tkircher/Espresso_vacuum/README.md

# Espresso vacuum
Released under the Permissive version of the Cern Open Hardware License v2 (CERN-OHL-P)
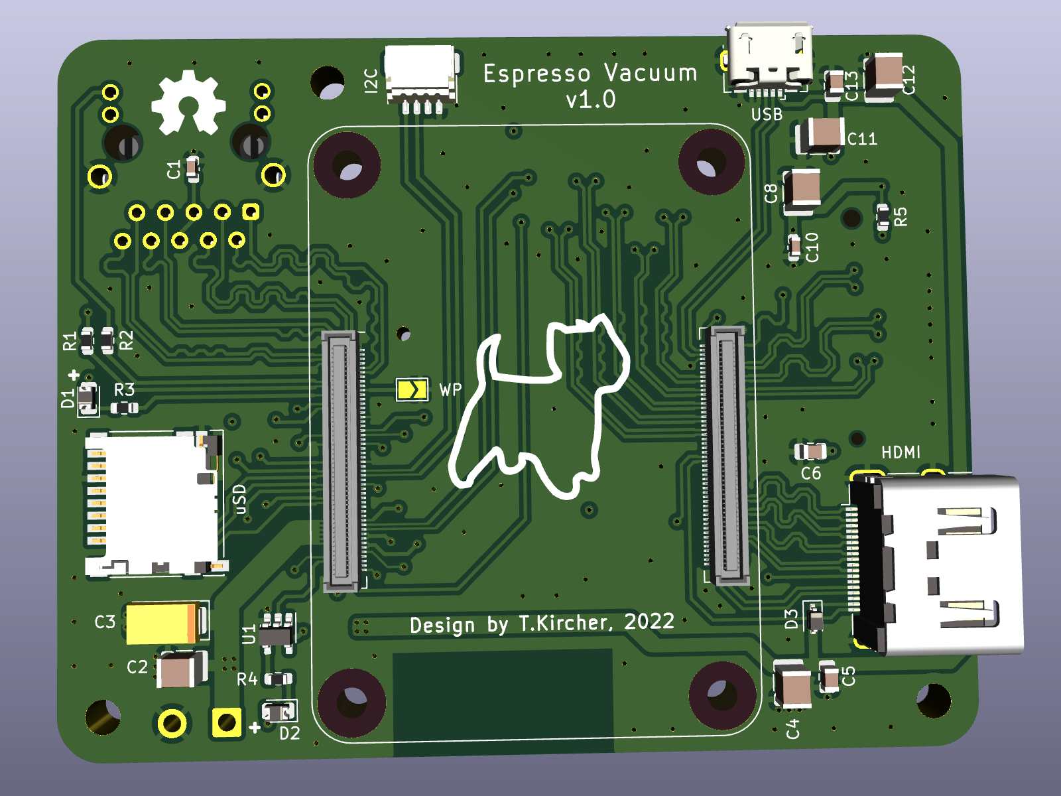
[picture p1: Espresso_vacuum_front.png]
Board front view

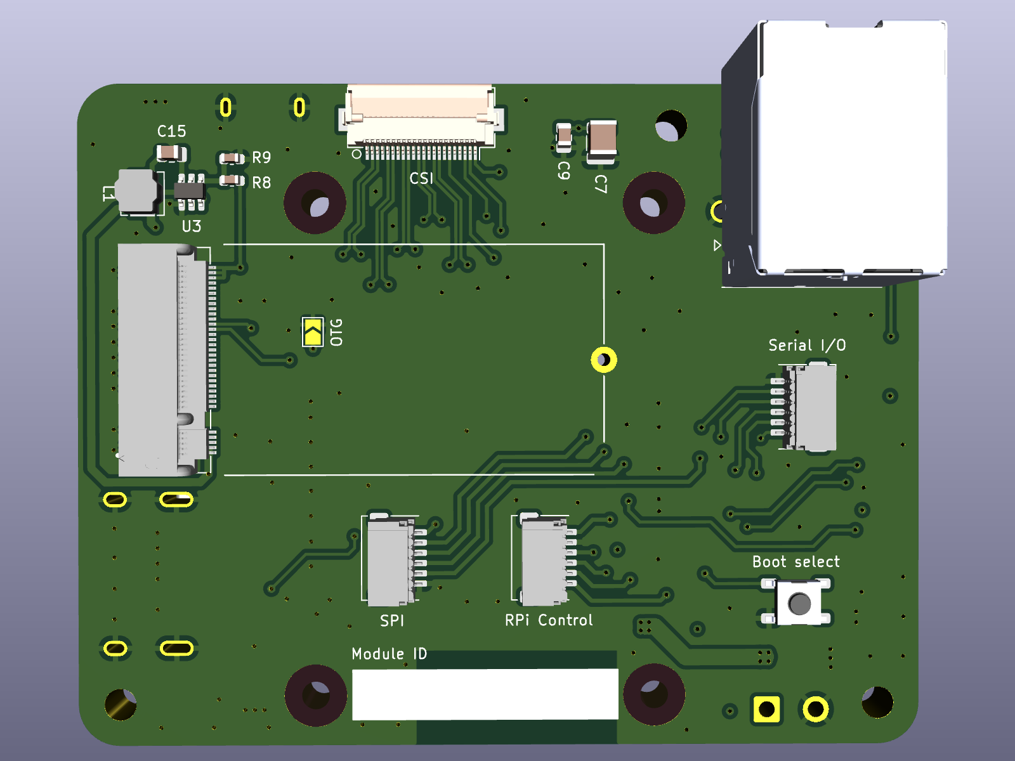
[picture p2: Espresso_vacuum_back.png]
Board back view
