tkircher/Espresso_vacuum/3D_models/Molex_501568-0607.step

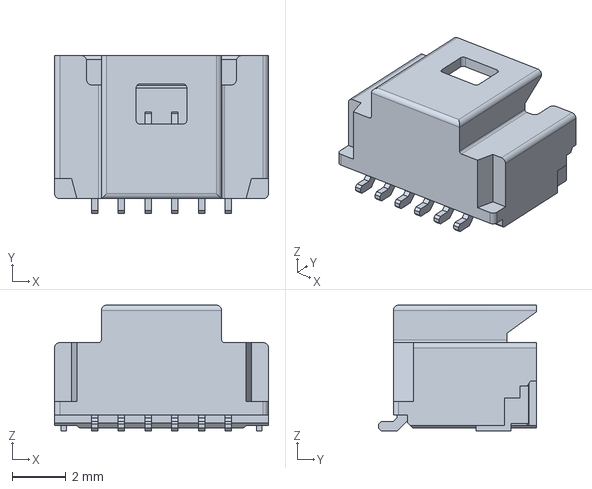
[picture p3: CAD file, 2023-04-29]
3D_models/Molex_501568-0607.step
8.00 x 5.90 x 4.70 mm
