tkircher/Espresso_vacuum/3D_models/SM04B-SRSS-TB(LF)(SN).step

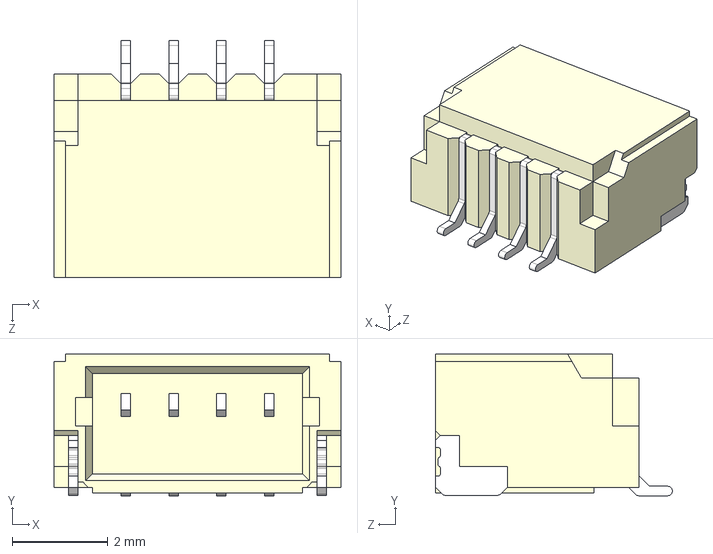
[picture p4: CAD file, 2023-04-29]
3D_models/SM04B-SRSS-TB(LF)(SN).step
6.00 x 2.96 x 4.95 mm
