tkircher/Espresso_vacuum/3D_models/MJTP1140ATR_pushbutton.step

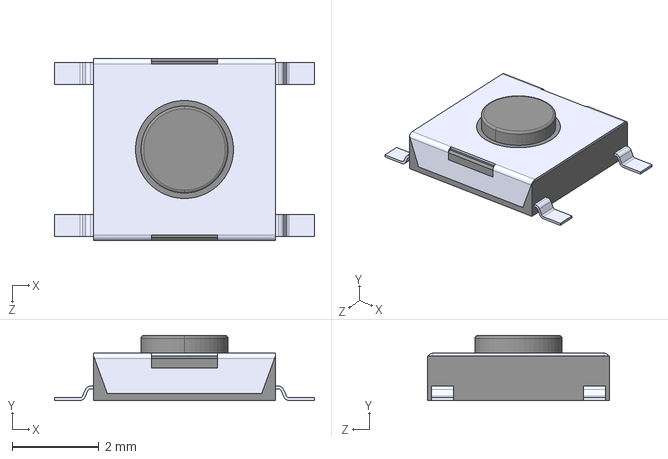
[picture p5: CAD file, 2023-04-29]
3D_models/MJTP1140ATR_pushbutton.step
5.99 x 1.50 x 4.19 mm
