tkircher/Espresso_vacuum/3D_models/srr5028-220y.step

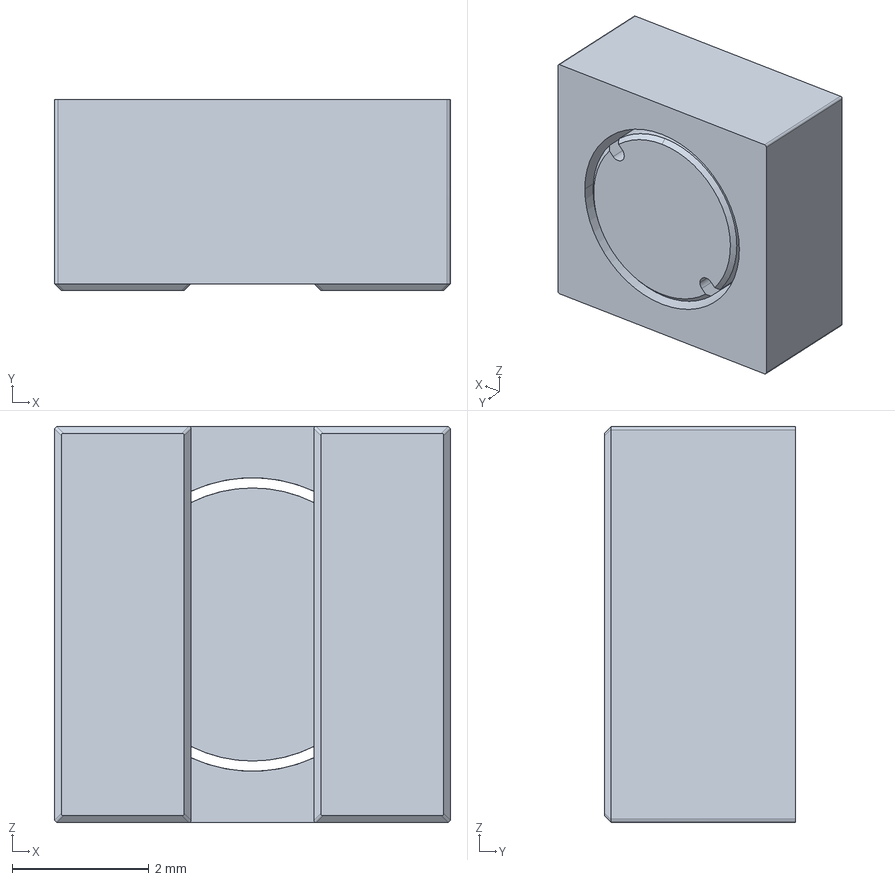
[picture p6: CAD file, 2023-04-29]
3D_models/srr5028-220y.step
5.80 x 2.80 x 5.80 mm
