tkircher/Espresso_vacuum/3D_models/microSD_HC_Hirose_DM3D-SF.step

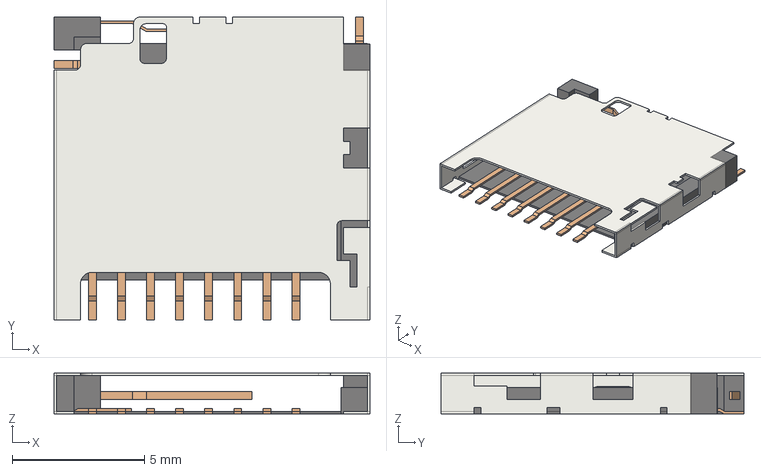
[picture p7: CAD file, 2023-04-29]
3D_models/microSD_HC_Hirose_DM3D-SF.step
11.9 x 11.5 x 1.55 mm
