tkircher/Espresso_vacuum/3D_models/Amphenol_10147606-00006LF.step

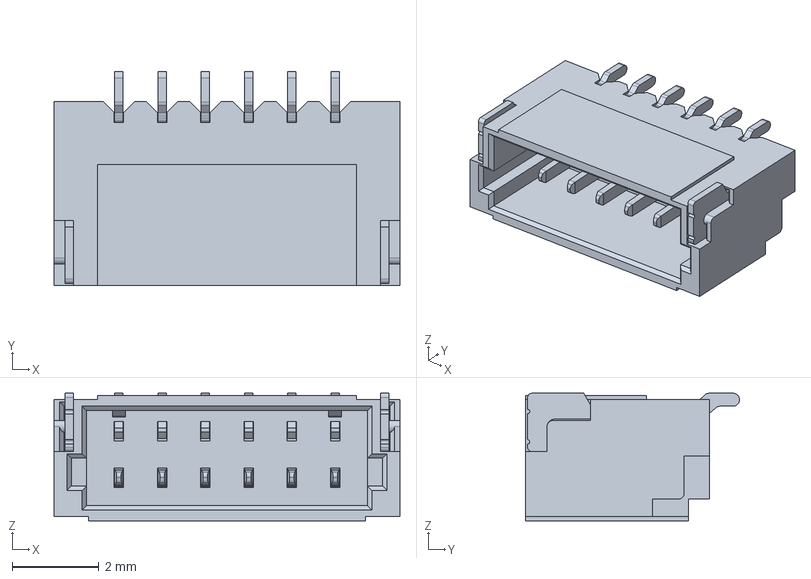
[picture p8: CAD file, 2023-04-29]
3D_models/Amphenol_10147606-00006LF.step
8.00 x 4.95 x 2.95 mm
