tkircher/Espresso_vacuum/3D_models/DF40HC-3.0-100DS-0.4V.step

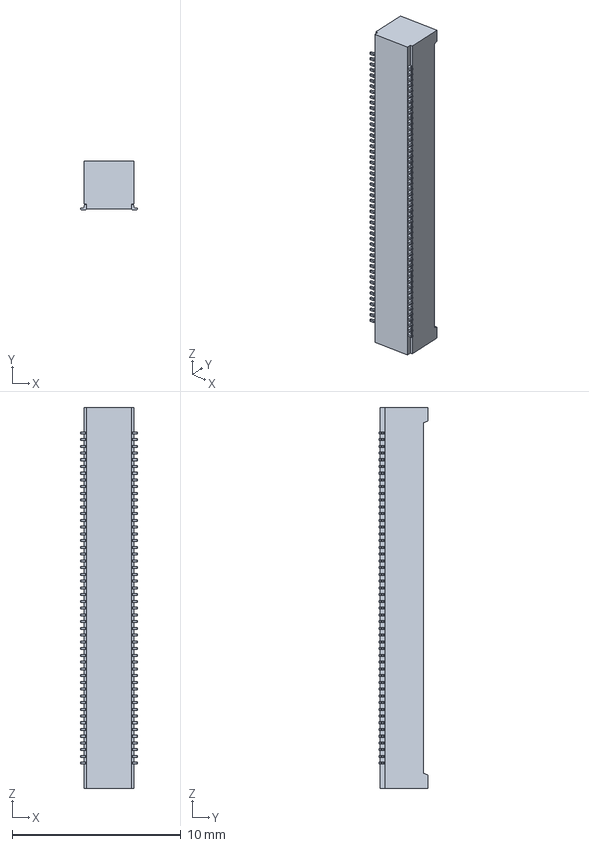
[picture p9: CAD file, 2023-04-29]
3D_models/DF40HC-3.0-100DS-0.4V.step
3.38 x 2.90 x 22.6 mm
