tkircher/Espresso_vacuum/3D_models/TL3301AF260QG.step

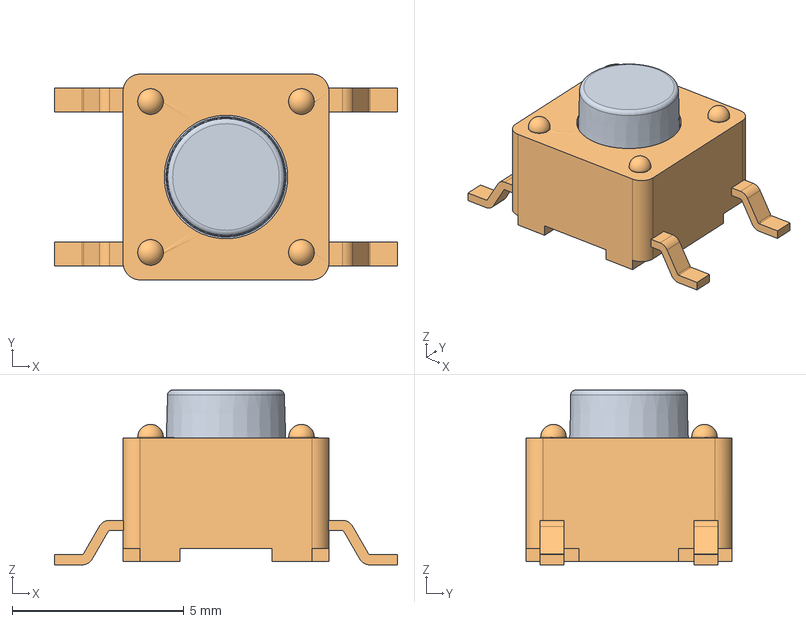
[picture p10: CAD file, 2023-04-29]
3D_models/TL3301AF260QG.step
10.0 x 6.00 x 5.10 mm
