tkircher/Espresso_vacuum/3D_models/USB_Micro-B_Molex_47346-0001.step

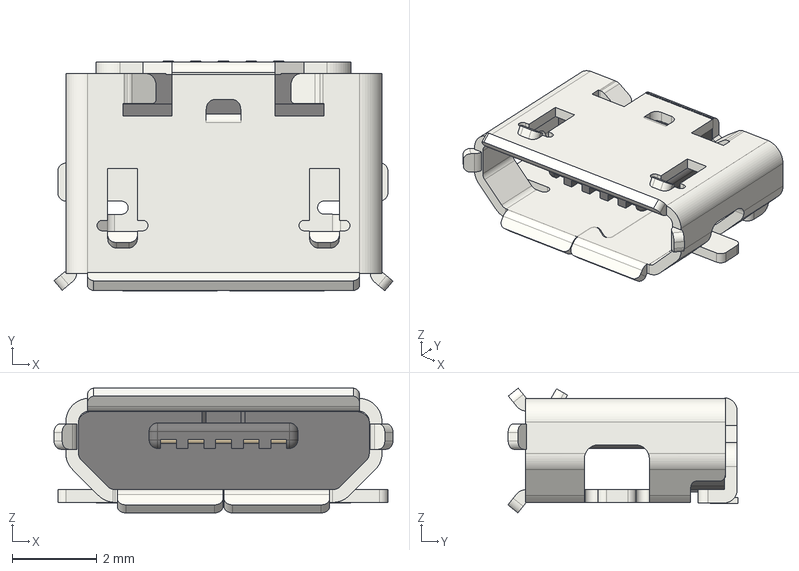
[picture p11: CAD file, 2023-04-29]
3D_models/USB_Micro-B_Molex_47346-0001.step
7.98 x 5.42 x 2.94 mm
