tkircher/Espresso_vacuum/3D_models/TE_2199119-3.step

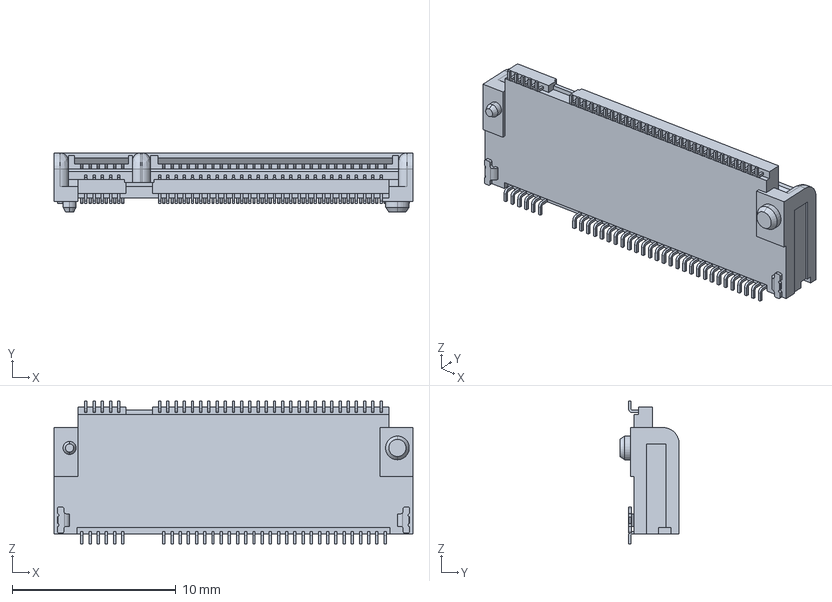
[picture p12: CAD file, 2023-04-29]
3D_models/TE_2199119-3.step
21.9 x 3.62 x 8.70 mm
