tkircher/Espresso_vacuum/3D_models/FH12-22S-0_5SH_55.step

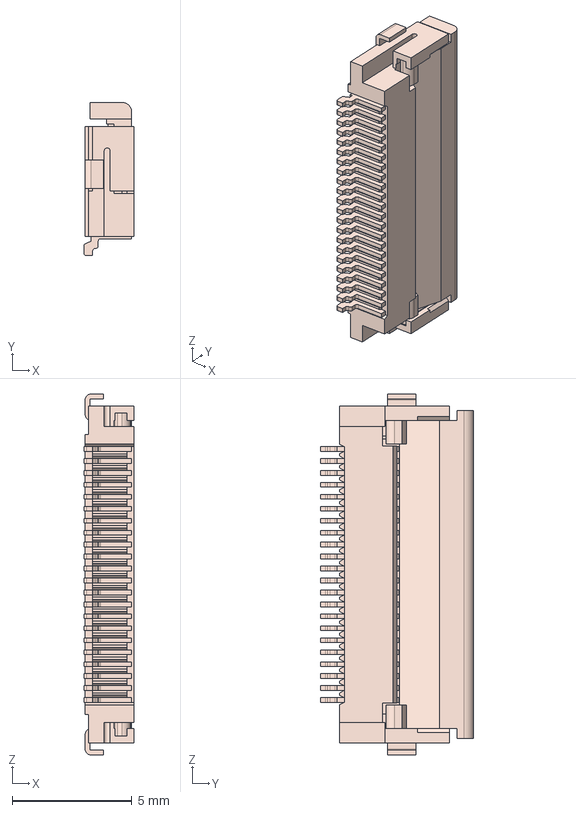
[picture p13: CAD file, 2023-04-29]
3D_models/FH12-22S-0_5SH_55.step
2.10 x 6.40 x 15.1 mm
