tkircher/Espresso_vacuum/3D_models/LQH44PN2R2MP0L.step

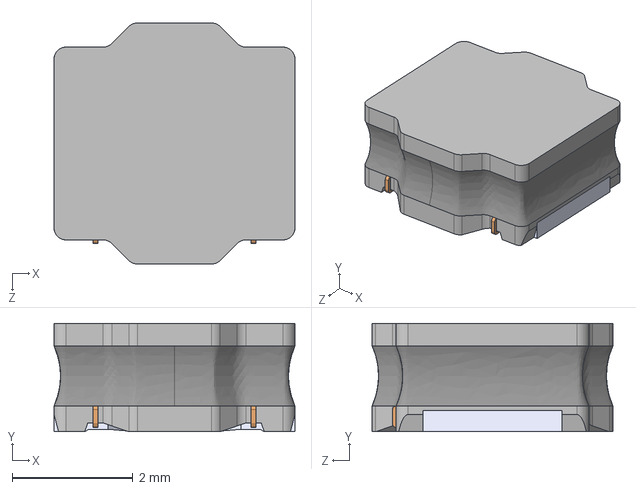
[picture p14: CAD file, 2023-04-29]
3D_models/LQH44PN2R2MP0L.step
4.00 x 1.80 x 4.00 mm
