tkircher/Espresso_vacuum/(threads)

Thread 1 (2023-08-28):

Tested?

samuk, 2023-08-28:
This looks nice, has it been fabbed/ tested?

tkircher, 2023-08-28:
Yes, all interfaces tested successfully, including CSI camera, ethernet, and NVMe SSD on the M.2. Photo of the first test board attached.

The release version has a few minor modifications to clean up the silkscreen and simplify assembly. I moved the HDMI blocking diode from the back to the front, for example, so that a fully functional board with HDMI, USB, MicroSD, and I2C can be reflowed with components on only one side. I'll post photos of that when I get a chance.

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

samuk, 2023-08-29:
Great! Do you have any plans to sell them anywhere?

tkircher, 2023-08-29:
No. When it became clear that RPi compute modules were never going to be available again, I designed a new board around an NXP processor instead. I released the project files for this because I have no intention of doing anything more with it.
