tkircher/Espresso_vacuum/Espresso_vacuum_v1.kicad_pcb

## KiCad design Espresso_vacuum_v1.kicad_pcb (2023-04-29)

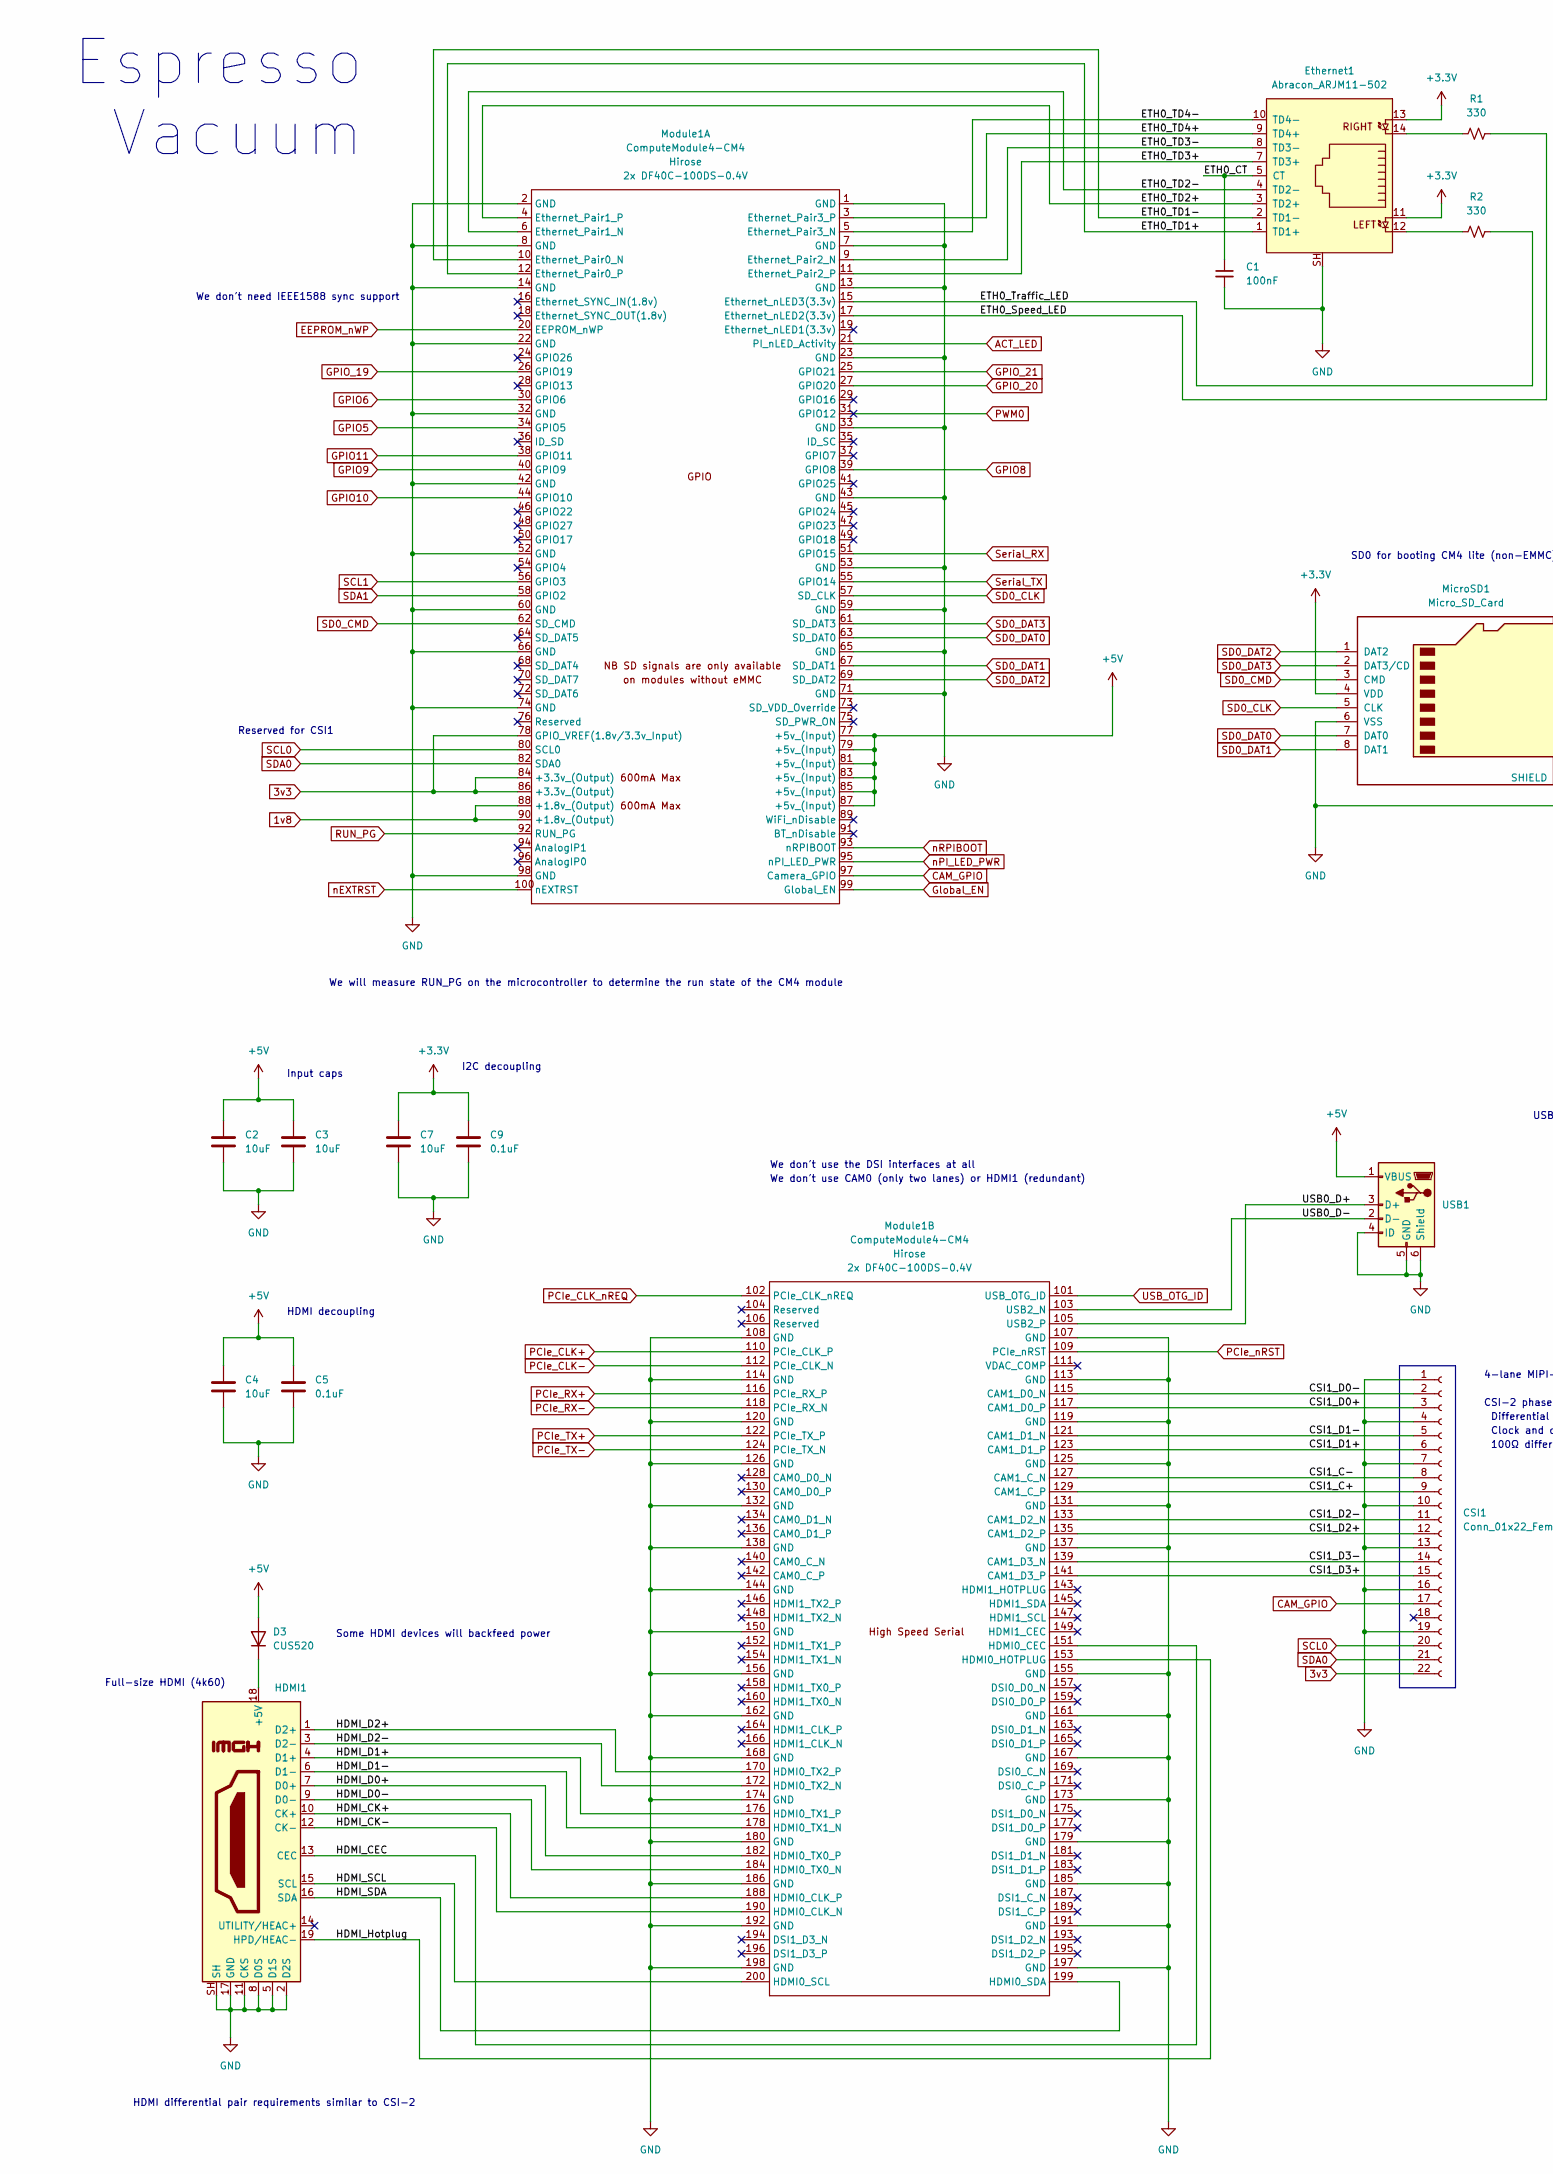
[picture p15: schematic Espresso_vacuum_v1.kicad_sch, Espresso Vacuum, part in row 1, column 1]

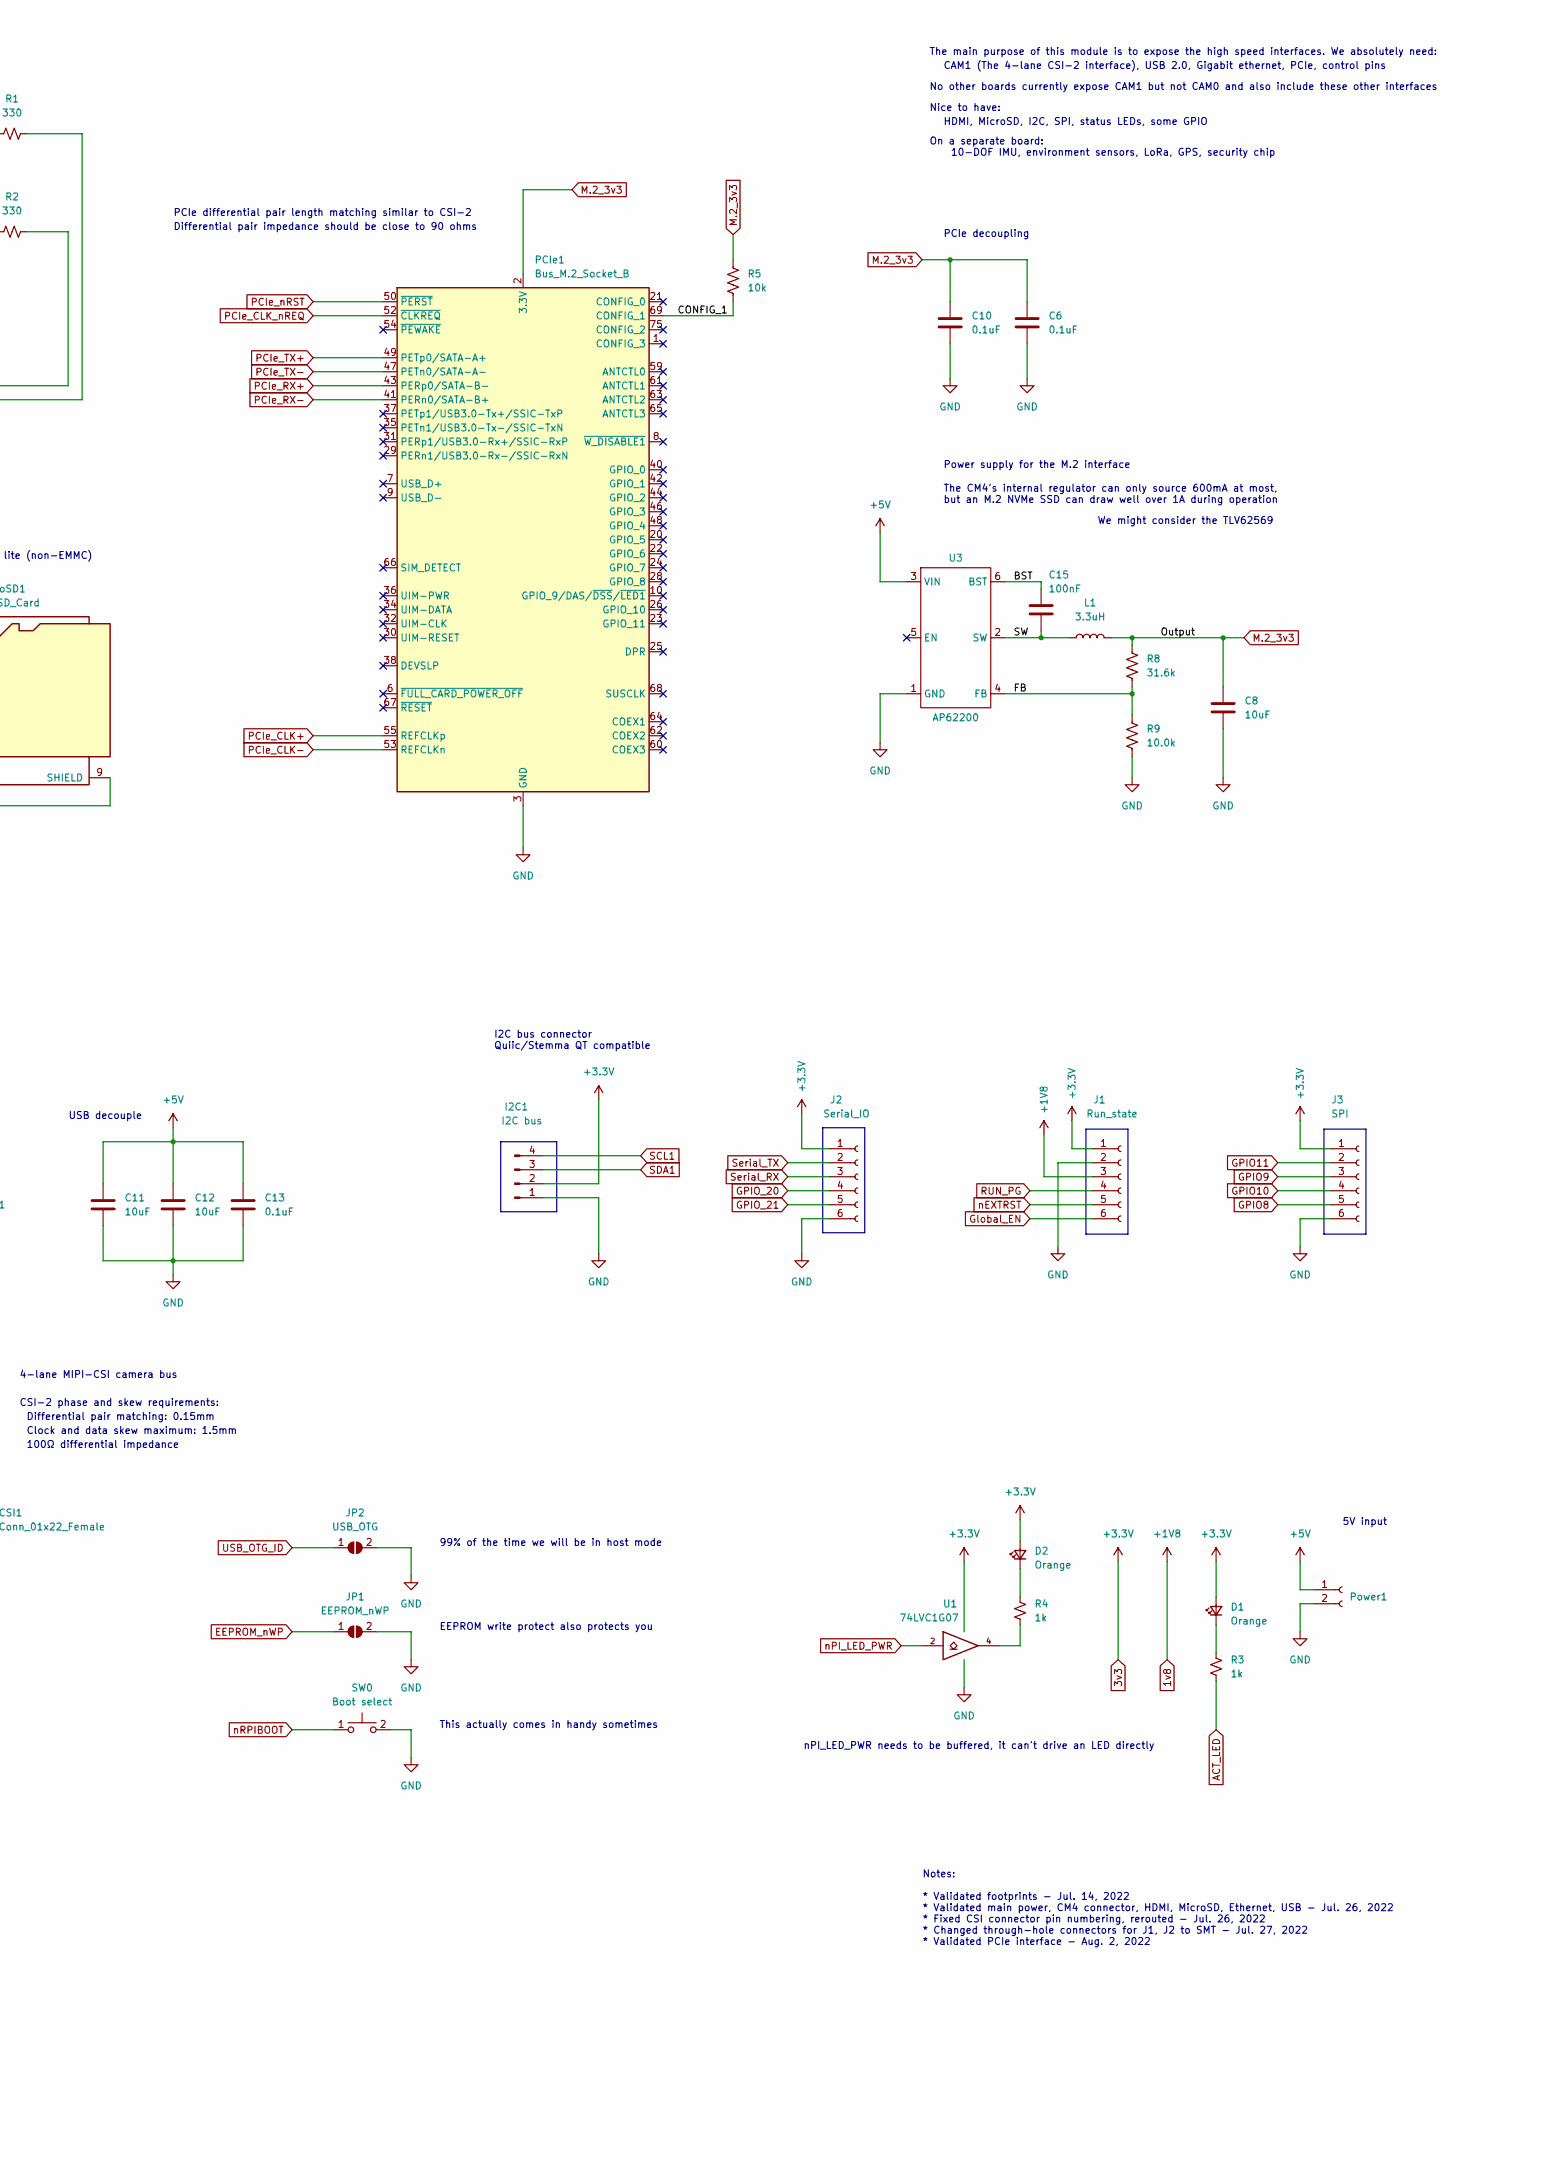
[picture p16: schematic Espresso_vacuum_v1.kicad_sch, Espresso Vacuum, part in row 1, column 2]

Parts:
C1: 100nF; C_0603_1608Metric
C2, C4, C7, C8, C11, C12: 10uF; C_1210_3225Metric
C3: 10uF; CP_EIA-6032-15_Kemet-U
C5, C6, C9, C13: 0.1uF; C_0805_2012Metric
C10: 0.1uF; C_0603_1608Metric
C15: 100nF; C_0805_2012Metric
CSI1: Conn_01x22_Female; Hirose_FH12-22S-0.5SH_1x22-1MP_P0.50mm_Horizontal
D1, D2: Orange; D_0805_2012Metric
D3: CUS520; D_SOD-323
Ethernet1: Abracon_ARJM11-502; RJ45_Abracon_ARJM11
HDMI1: Display_connector; HDMI_A_Molex_208658-1001_Horizontal
I2C1: I2C bus; JST_SH_SM04B-SRSS-TB_1x04-1MP_P1.00mm_Horizontal
J1: Run_state; Molex_Pico-Clasp_202396-0607_1x06-1MP_P1.00mm_Horizontal
J2: Serial_IO; Molex_Pico-Clasp_202396-0607_1x06-1MP_P1.00mm_Horizontal
J3: SPI; Molex_Pico-Clasp_202396-0607_1x06-1MP_P1.00mm_Horizontal
JP1: EEPROM_nWP; SolderJumper-2_P1.3mm_Open_TrianglePad1.0x1.5mm
JP2: USB_OTG; SolderJumper-2_P1.3mm_Open_TrianglePad1.0x1.5mm
L1: 3.3uH; Murata_4040
MicroSD1: Micro_SD_Card; microSD_HC_Hirose_DM3D-SF
Module1: ComputeModule4-CM4; Raspberry-Pi-4-Compute-Module
PCIe1: Bus_M.2_Socket_B; TE_2199119-3
Power1: Conn_01x02_Female; SolderWire-0.75sqmm_1x02_P4.8mm_D1.25mm_OD2.3mm
R1, R2: 330; R_0603_1608Metric
R3, R4: 1k; R_0603_1608Metric
R5: 10k; R_0603_1608Metric
R8: 31.6k; C_0603_1608Metric
R9: 10.0k; C_0603_1608Metric
SW0: Boot select; MJTP1140A
U1: 74LVC1G07; SOT-23-5
U3: AP62200; TSOT-23-6
USB1: microUSB; USB_Micro-B_GCT_USB3076-30-A

Connections:
1v8: J1.3, Module1.88 (+1.8v_(Output)), Module1.90 (+1.8v_(Output))
3v3: C7.1, C9.1, CSI1.22, D1.2 (A), D2.2 (A), Ethernet1.11, Ethernet1.13, I2C1.2, J1.1, J2.1, J3.1, MicroSD1.4 (VDD), Module1.78 (GPIO_VREF(1.8v/3.3v_Input)), Module1.84 (+3.3v_(Output)), Module1.86 (+3.3v_(Output)), U1.5 (VCC)
+5V: C2.1, C3.1, C4.1, C5.1, C11.1, C12.1, C13.1, D3.2 (A), Module1.77 (+5v_(Input)), Module1.79 (+5v_(Input)), Module1.81 (+5v_(Input)), Module1.83 (+5v_(Input)), Module1.85 (+5v_(Input)), Module1.87 (+5v_(Input)), Power1.1, U3.3 (VIN), USB1.1 (VBUS)
/BST: C15.1, U3.6 (BST)
/CONFIG_1: PCIe1.69 (CONFIG_1), R5.2
/CSI1_C+: CSI1.9, Module1.129 (CAM1_C_P)
/CSI1_C-: CSI1.8, Module1.127 (CAM1_C_N)
/CSI1_D0+: CSI1.3, Module1.117 (CAM1_D0_P)
/CSI1_D0-: CSI1.2, Module1.115 (CAM1_D0_N)
/CSI1_D1+: CSI1.6, Module1.123 (CAM1_D1_P)
/CSI1_D1-: CSI1.5, Module1.121 (CAM1_D1_N)
/CSI1_D2+: CSI1.12, Module1.135 (CAM1_D2_P)
/CSI1_D2-: CSI1.11, Module1.133 (CAM1_D2_N)
/CSI1_D3+: CSI1.15, Module1.141 (CAM1_D3_P)
/CSI1_D3-: CSI1.14, Module1.139 (CAM1_D3_N)
/ETH0_CT: C1.1, Ethernet1.5 (CT), Ethernet1.6 (CT)
/ETH0_Speed_LED: Module1.17 (Ethernet_nLED2(3.3v)), R1.1
/ETH0_TD1+: Ethernet1.1 (TD1+), Module1.12 (Ethernet_Pair0_P)
/ETH0_TD1-: Ethernet1.2 (TD1-), Module1.10 (Ethernet_Pair0_N)
/ETH0_TD2+: Ethernet1.3 (TD2+), Module1.4 (Ethernet_Pair1_P)
/ETH0_TD2-: Ethernet1.4 (TD2-), Module1.6 (Ethernet_Pair1_N)
/ETH0_TD3+: Ethernet1.7 (TD3+), Module1.11 (Ethernet_Pair2_P)
/ETH0_TD3-: Ethernet1.8 (TD3-), Module1.9 (Ethernet_Pair2_N)
/ETH0_TD4+: Ethernet1.9 (TD4+), Module1.3 (Ethernet_Pair3_P)
/ETH0_TD4-: Ethernet1.10 (TD4-), Module1.5 (Ethernet_Pair3_N)
/ETH0_Traffic_LED: Module1.15 (Ethernet_nLED3(3.3v)), R2.1
/FB: R8.2, R9.1, U3.4 (FB)
/HDMI_CEC: HDMI1.13 (CEC), Module1.151 (HDMI0_CEC)
/HDMI_CK+: HDMI1.10 (CK+), Module1.188 (HDMI0_CLK_P)
/HDMI_CK-: HDMI1.12 (CK-), Module1.190 (HDMI0_CLK_N)
/HDMI_D0+: HDMI1.7 (D0+), Module1.182 (HDMI0_TX0_P)
/HDMI_D0-: HDMI1.9 (D0-), Module1.184 (HDMI0_TX0_N)
/HDMI_D1+: HDMI1.4 (D1+), Module1.176 (HDMI0_TX1_P)
/HDMI_D1-: HDMI1.6 (D1-), Module1.178 (HDMI0_TX1_N)
/HDMI_D2+: HDMI1.1 (D2+), Module1.170 (HDMI0_TX2_P)
/HDMI_D2-: HDMI1.3 (D2-), Module1.172 (HDMI0_TX2_N)
/HDMI_Hotplug: HDMI1.19 (HPD/HEAC-), Module1.153 (HDMI0_HOTPLUG)
/HDMI_SCL: HDMI1.15 (SCL), Module1.200 (HDMI0_SCL)
/HDMI_SDA: HDMI1.16 (SDA), Module1.199 (HDMI0_SDA)
/SW: C15.2, L1.1, U3.2 (SW)
/USB0_D+: Module1.105 (USB2_P), USB1.3 (D+)
/USB0_D-: Module1.103 (USB2_N), USB1.2 (D-)
ACT_LED: Module1.21 (PI_nLED_Activity), R3.1
CAM_GPIO: CSI1.17, Module1.97 (Camera_GPIO)
EEPROM_nWP: JP1.1 (A), Module1.20 (EEPROM_nWP)
GND: C1.2, C2.2, C3.2, C4.2, C5.2, C6.2, C7.2, C8.2, C9.2, C10.2, C11.2, C12.2, C13.2, CSI1.1, CSI1.4, CSI1.7, CSI1.10, CSI1.13, CSI1.16, CSI1.19, Ethernet1.SH, HDMI1.2 (D2S), HDMI1.5 (D1S), HDMI1.8 (D0S), HDMI1.11 (CKS), HDMI1.17 (GND), HDMI1.SH, I2C1.1, J1.2, J2.6, J3.6, JP1.2 (B), JP2.2 (B), MicroSD1.6 (VSS), MicroSD1.9 (SHIELD), Module1.1 (GND), Module1.2 (GND), Module1.7 (GND), Module1.8 (GND), Module1.13 (GND), Module1.14 (GND), Module1.22 (GND), Module1.23 (GND), Module1.32 (GND), Module1.33 (GND), Module1.42 (GND), Module1.43 (GND), Module1.52 (GND), Module1.53 (GND), Module1.59 (GND), Module1.60 (GND), Module1.65 (GND), Module1.66 (GND), Module1.71 (GND), Module1.74 (GND), Module1.98 (GND), Module1.107 (GND), Module1.108 (GND), Module1.113 (GND), Module1.114 (GND), Module1.119 (GND), Module1.120 (GND), Module1.125 (GND), Module1.126 (GND), Module1.131 (GND), Module1.132 (GND), Module1.137 (GND), Module1.138 (GND), Module1.144 (GND), Module1.150 (GND), Module1.155 (GND), Module1.156 (GND), Module1.161 (GND), Module1.162 (GND), Module1.167 (GND), Module1.168 (GND), Module1.173 (GND), Module1.174 (GND), Module1.179 (GND), Module1.180 (GND), Module1.185 (GND), Module1.186 (GND), Module1.191 (GND), Module1.192 (GND), Module1.197 (GND), Module1.198 (GND), PCIe1.3 (GND), PCIe1.5 (GND), PCIe1.11 (GND), PCIe1.27 (GND), PCIe1.33 (GND), PCIe1.39 (GND), PCIe1.45 (GND), PCIe1.51 (GND), PCIe1.57 (GND), PCIe1.71 (GND), PCIe1.73 (GND), Power1.2, R9.2, SW0.2, U1.3 (GND), U3.1 (GND), USB1.4 (ID), USB1.5 (GND), USB1.6 (Shield)
GPIO5: Module1.34 (GPIO5)
GPIO6: Module1.30 (GPIO6)
GPIO8: J3.5, Module1.39 (GPIO8)
GPIO9: J3.3, Module1.40 (GPIO9)
GPIO10: J3.4, Module1.44 (GPIO10)
GPIO11: J3.2, Module1.38 (GPIO11)
GPIO_19: Module1.26 (GPIO19)
GPIO_20: J2.4, Module1.27 (GPIO20)
GPIO_21: J2.5, Module1.25 (GPIO21)
Global_EN: J1.6, Module1.99 (Global_EN)
M.2_3v3: C6.1, C8.1, C10.1, L1.2, PCIe1.2 (3.3V), PCIe1.4 (3.3V), PCIe1.70 (3.3V), PCIe1.72 (3.3V), PCIe1.74 (3.3V), R5.1, R8.1
unnamed: D1.1 (K), R3.2
unnamed: D2.1 (K), R4.2
unnamed: D3.1 (K), HDMI1.18 (+5V)
unnamed: Ethernet1.12, R2.2
unnamed: Ethernet1.14, R1.2
unnamed: R4.1, U1.4
PCIe_CLK+: Module1.110 (PCIe_CLK_P), PCIe1.55 (REFCLKp)
PCIe_CLK-: Module1.112 (PCIe_CLK_N), PCIe1.53 (REFCLKn)
PCIe_CLK_nREQ: Module1.102 (PCIe_CLK_nREQ), PCIe1.52 (~CLKREQ)
PCIe_RX+: Module1.116 (PCIe_RX_P), PCIe1.43 (PERp0/SATA-B-)
PCIe_RX-: Module1.118 (PCIe_RX_N), PCIe1.41 (PERn0/SATA-B+)
PCIe_TX+: Module1.122 (PCIe_TX_P), PCIe1.49 (PETp0/SATA-A+)
PCIe_TX-: Module1.124 (PCIe_TX_N), PCIe1.47 (PETn0/SATA-A-)
PCIe_nRST: Module1.109 (PCIe_nRST), PCIe1.50 (~PERST)
PWM0: Module1.31 (GPIO12)
RUN_PG: J1.4, Module1.92 (RUN_PG)
SCL0: CSI1.20, Module1.80 (SCL0)
SCL1: I2C1.4, Module1.56 (GPIO3)
SD0_CLK: MicroSD1.5 (CLK), Module1.57 (SD_CLK)
SD0_CMD: MicroSD1.3 (CMD), Module1.62 (SD_CMD)
SD0_DAT0: MicroSD1.7 (DAT0), Module1.63 (SD_DAT0)
SD0_DAT1: MicroSD1.8 (DAT1), Module1.67 (SD_DAT1)
SD0_DAT2: MicroSD1.1 (DAT2), Module1.69 (SD_DAT2)
SD0_DAT3: MicroSD1.2 (DAT3/CD), Module1.61 (SD_DAT3)
SDA0: CSI1.21, Module1.82 (SDA0)
SDA1: I2C1.3, Module1.58 (GPIO2)
Serial_RX: J2.3, Module1.51 (GPIO15)
Serial_TX: J2.2, Module1.55 (GPIO14)
USB_OTG_ID: JP2.1 (A), Module1.101 (USB_OTG_ID)
nEXTRST: J1.5, Module1.100 (nEXTRST)
nPI_LED_PWR: Module1.95 (nPI_LED_PWR), U1.2
nRPIBOOT: Module1.93 (nRPIBOOT), SW0.1

Notes on the sheet:
4-lane MIPI-CSI camera bus
Espresso Vacuum
Differential pair matching: 0.15mm
nPI_LED_PWR needs to be buffered, it can't drive an LED directly
USB decouple
On a separate board: 10-DOF IMU, environment sensors, LoRa, GPS, security chip
HDMI, MicroSD, I2C, SPI, status LEDs, some GPIO
This actually comes in handy sometimes
CAM1 (The 4-lane CSI-2 interface), USB 2.0, Gigabit ethernet, PCIe, control pins
Full-size HDMI (4k60)
100Ω differential impedance
Input caps
Some HDMI devices will backfeed power
HDMI decoupling
No other boards currently expose CAM1 but not CAM0 and also include these other interfaces
CSI-2 phase and skew requirements:
5V input
Differential pair impedance should be close to 90 ohms
Clock and data skew maximum: 1.5mm
HDMI differential pair requirements similar to CSI-2
Reserved for CSI1
I2C decoupling
We will measure RUN_PG on the microcontroller to determine the run state of the CM4 module
PCIe differential pair length matching similar to CSI-2
EEPROM write protect also protects you
99% of the time we will be in host mode
We don't use CAM0 (only two lanes) or HDMI1 (redundant)
I2C bus connector Quiic/Stemma QT compatible
We don't need IEEE1588 sync support
Power supply for the M.2 interface
Nice to have:
PCIe decoupling
The CM4's internal regulator can only source 600mA at most, but an M.2 NVMe SSD can draw well over 1A during operation
The main purpose of this module is to expose the high speed interfaces. We absolutely need:
SD0 for booting CM4 lite (non-EMMC)
We might consider the TLV62569
We don't use the DSI interfaces at all
Notes: * Validated footprints - Jul. 14, 2022 * Validated main power, CM4 connector, HDMI, MicroSD, Ethernet, USB - Jul. 26, 2022 * Fixed CSI connector pin numbering, rerouted - Jul. 26, 2022 * Changed through-hole connectors for J1, J2 to SMT - Jul. 27, 2022 * Validated PCIe interface - Aug. 2, 20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

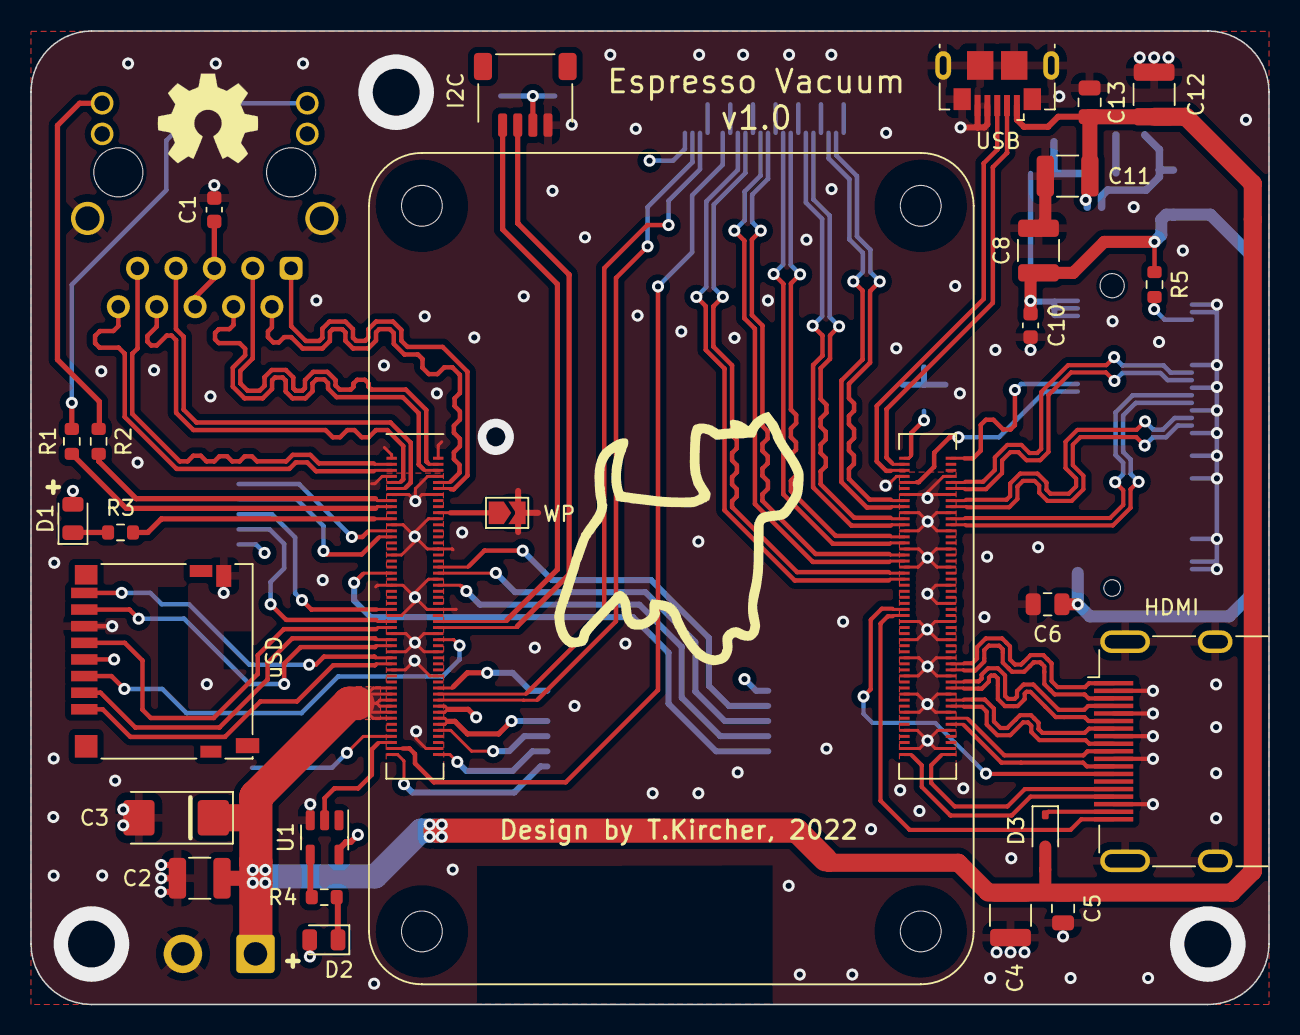
[picture p17: board Espresso_vacuum_v1.kicad_pcb from above]

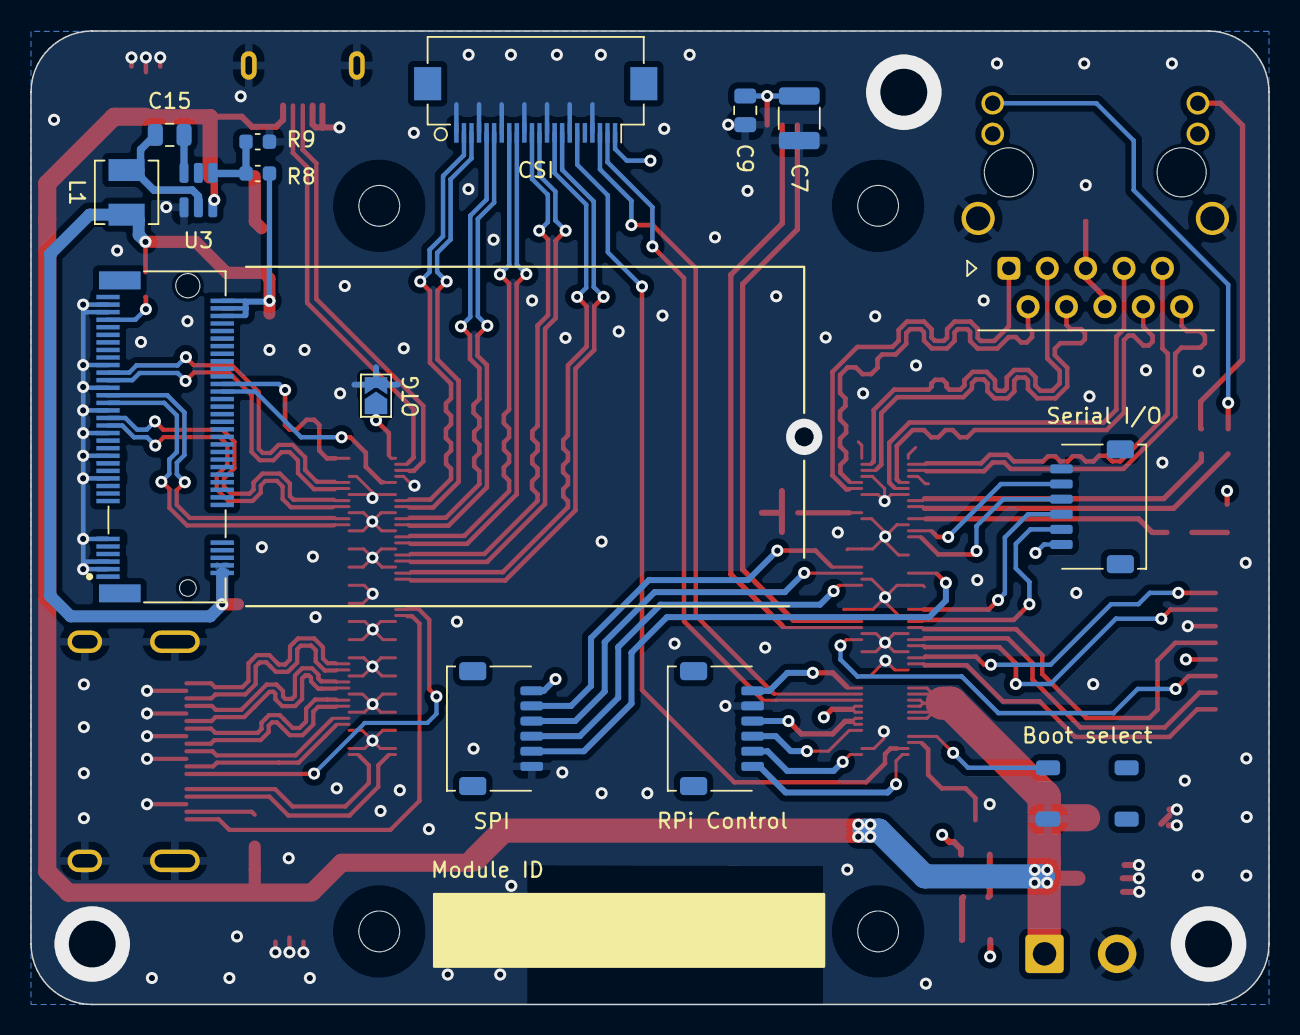
[picture p18: board Espresso_vacuum_v1.kicad_pcb from below]

Board: 4 copper layers, 81.9 x 64.4 mm, 42 parts (15 on the bottom side), 85 nets.
