tkircher/Espresso_vacuum/(commit log)

2023-04-29 Add files via upload
    Initial upload
    [Amphenol_10147606-00006LF.step, DF40HC-3.0-100DS-0.4V.step, Espresso_vacuum_v1.kicad_pcb, Espresso_vacuum_v1.kicad_sch, FH12-22S-0_5SH_55.step, LQH44PN2R2MP0L.step, MJTP1140ATR_pushbutton.step, Molex_501568-0607.step]
2023-04-30 Added board render
