tkircher/Espresso_vacuum/(notices)

Notices in the files:
3D_models/Molex_501568-0607.step:
FILE_NAME( 'C:/Users/KMIROS~1/AppData/Local/Temp/psolqas_20056_8.stp', '2020-07-10T06:50:59', ( 'License CC BY-ND 4.0' ), ( 'CADENAS' ), ' ', 'PARTsolutions', ' ' );
